abdelrahmaneldeib/sumo-robot/rendering/prototype IR with PCB 1.jpg

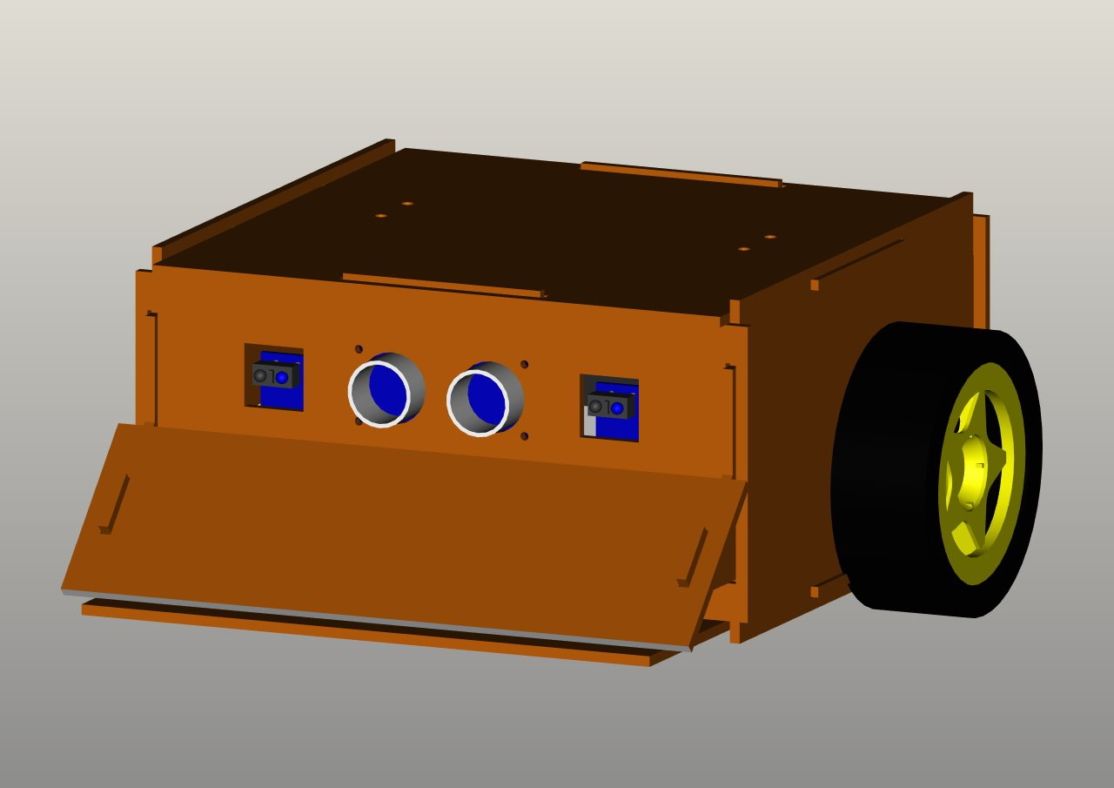
rendering/prototype IR with PCB 1.jpg
