abdelrahmaneldeib/sumo-robot/PCB/final/WhatsApp Image 2023-05-24 at 13.45.49.jpg

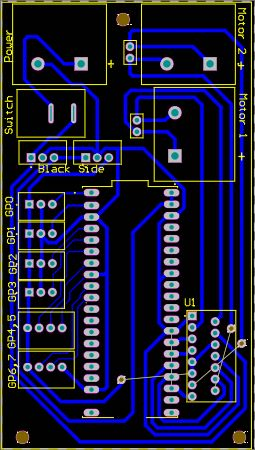
PCB/final/WhatsApp Image 2023-05-24 at 13.45.49.jpg
