abdelrahmaneldeib/sumo-robot/README.md

# sumo-robot
Welcome to an exciting project that showcases the design and development of a Sumo robot tailored to meet the specific goals and requirements of our esteemed client This project not only emphasizes technical prowess but also ingenuity and creativity in engineering solutions.
