abdelrahmaneldeib/sumo-robot/rendering/prototype IR with PCB 2.jpg

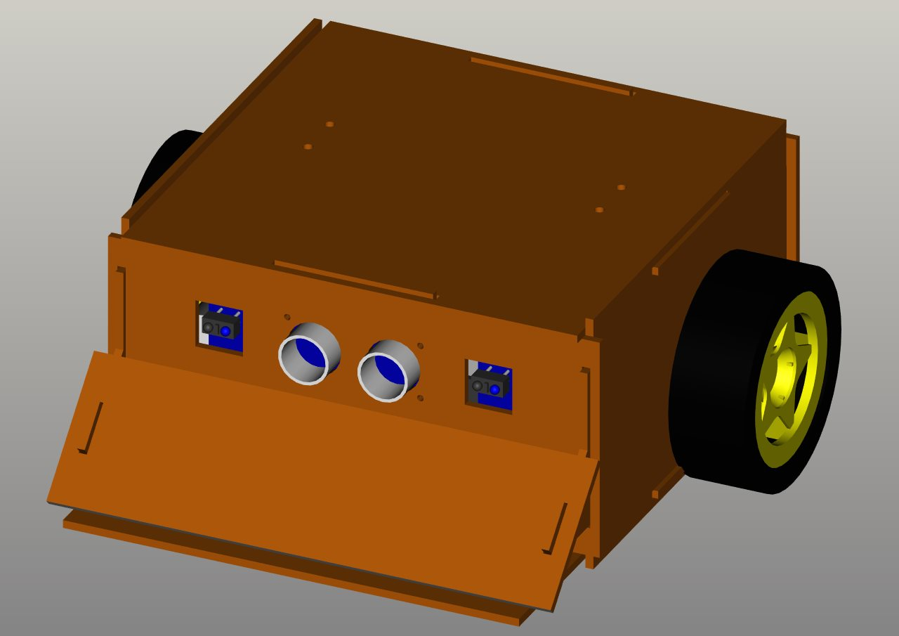
rendering/prototype IR with PCB 2.jpg
