abdelrahmaneldeib/sumo-robot/rendering/prototype IR with PCB 3.jpg

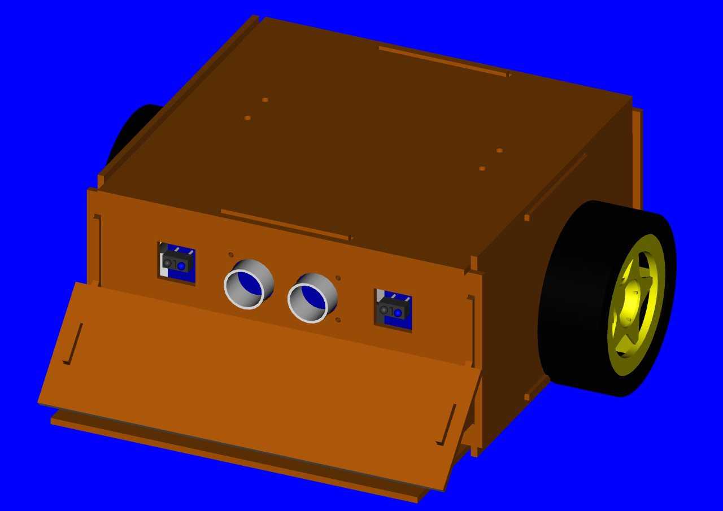
rendering/prototype IR with PCB 3.jpg
