abdelrahmaneldeib/sumo-robot/rendering/prototype IR with PCB 4.jpg

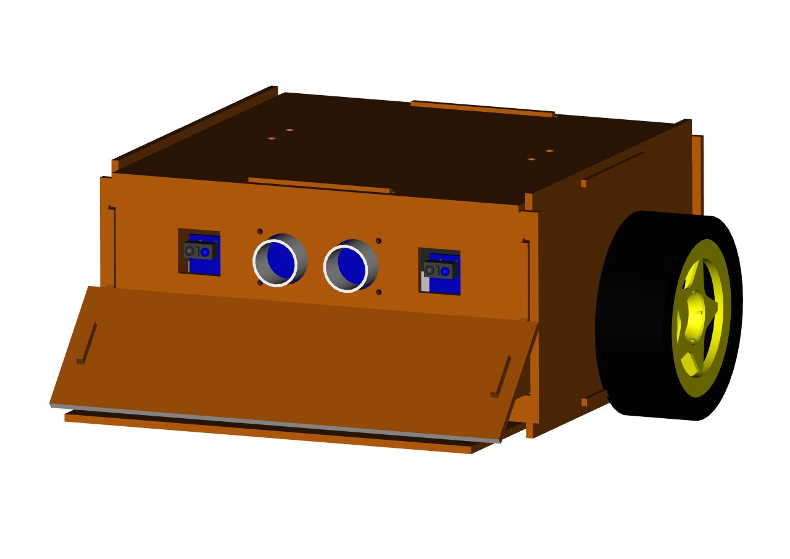
rendering/prototype IR with PCB 4.jpg
