abdelrahmaneldeib/sumo-robot/Design/prototype/prototype US.SLDASM

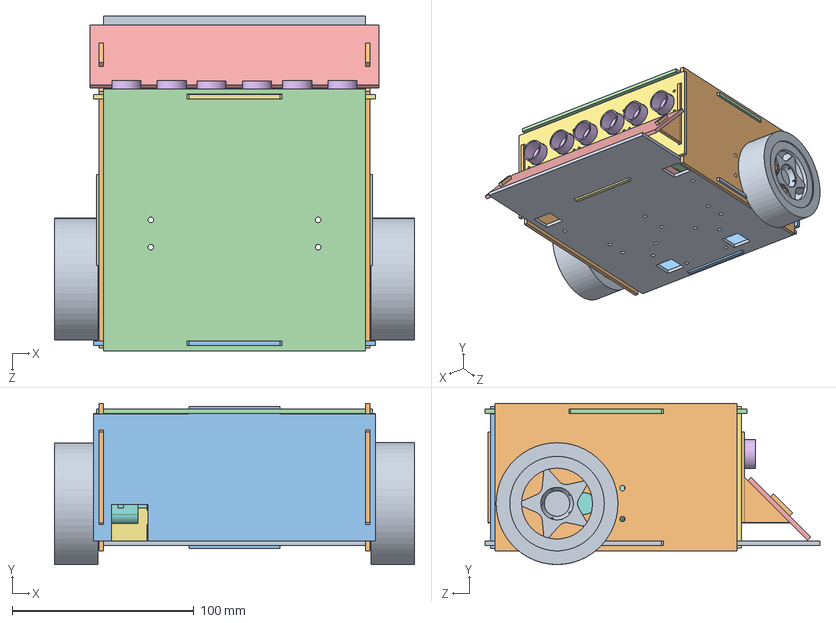
[picture p28: CAD file, 2024-05-13]
Design/prototype/prototype US.SLDASM
198.0 x 88.7 x 184.2 mm
bottom
side x 2
back
battery holder
breadboard x 2
IR sensor x 4
motor driver
motor x 2
wheel x 2
black disk x 2
encoder x 2
top
defender
ultrasonic sensor x 3
front2
