abdelrahmaneldeib/sumo-robot/Design/prototype/prototype IR with PCB.SLDASM

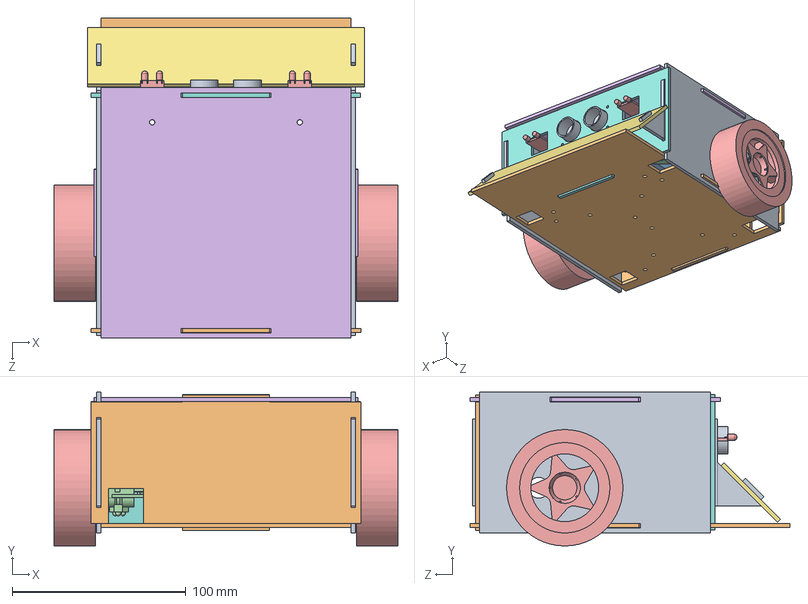
[picture p29: CAD file, 2024-05-13]
Design/prototype/prototype IR with PCB.SLDASM
198.0 x 88.6 x 184.3 mm
side x 2
back
battery holder
motor x 2
wheel x 2
top
defender
front
ultrasonic sensor
bottom2
PCB
IR sensor x 4
IR sensor 2 x 2
