abdelrahmaneldeib/sumo-robot/Design/final/battery holder 4 batteries.SLDPRT

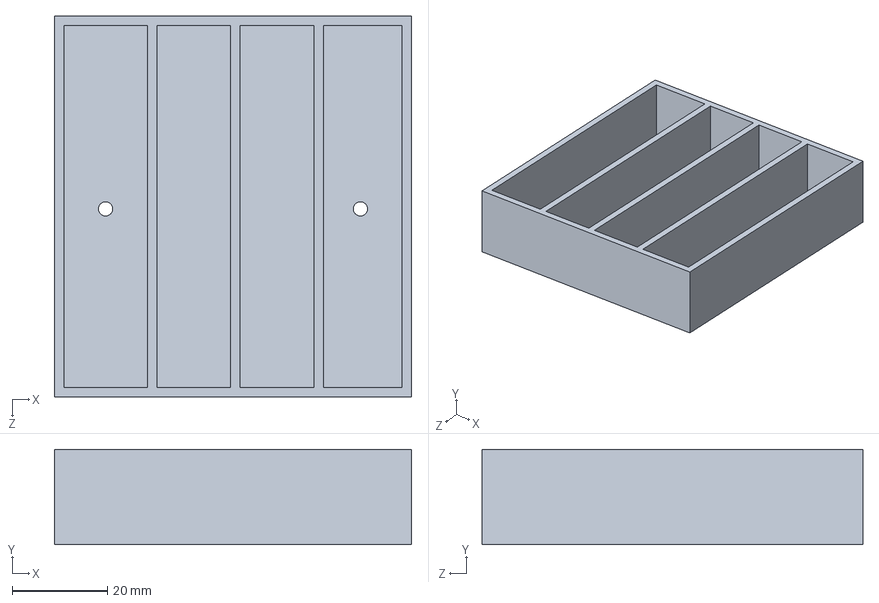
[picture p30: CAD file, 2024-05-13]
Design/final/battery holder 4 batteries.SLDPRT
75.0 x 20.0 x 80.0 mm
