abdelrahmaneldeib/sumo-robot/Design/final/top.SLDPRT

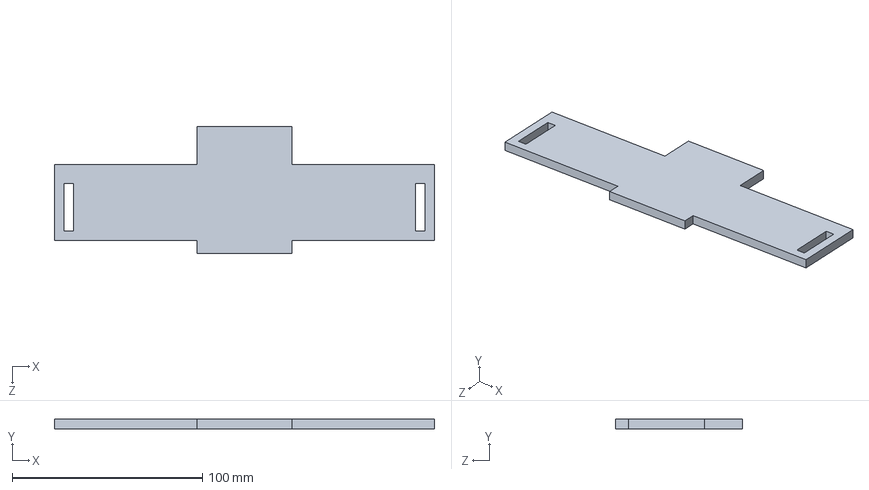
[picture p31: CAD file, 2024-05-13]
Design/final/top.SLDPRT
200.0 x 5.00 x 67.0 mm
