abdelrahmaneldeib/sumo-robot/Design/prototype/ultrasonic sensor.SLDPRT

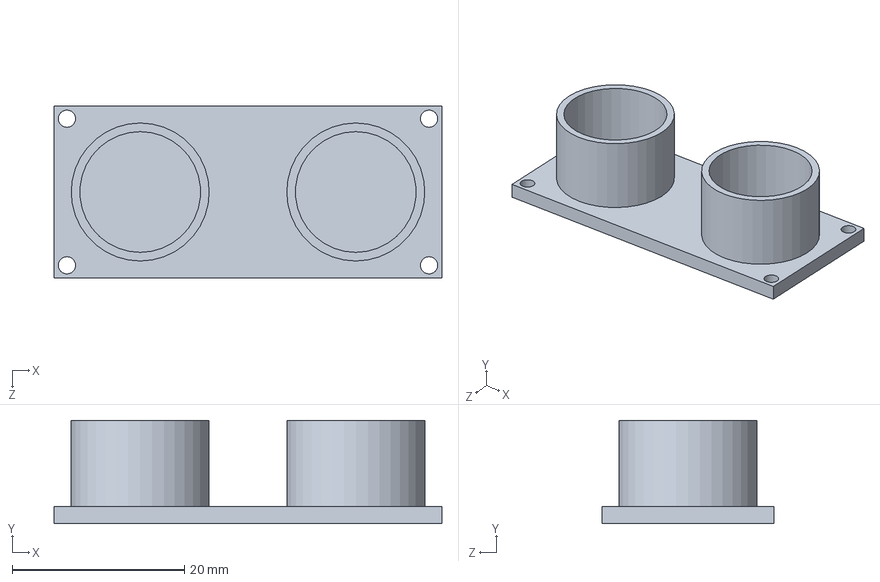
[picture p32: CAD file, 2024-05-13]
Design/prototype/ultrasonic sensor.SLDPRT
45.0 x 12.0 x 20.0 mm
