abdelrahmaneldeib/sumo-robot/Design/final/back.SLDPRT

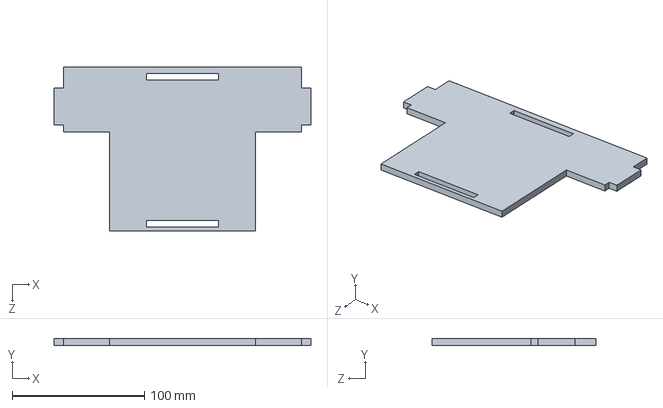
[picture p33: CAD file, 2024-05-13]
Design/final/back.SLDPRT
194.0 x 5.00 x 124.0 mm
