abdelrahmaneldeib/sumo-robot/Design/prototype/breadboard.SLDPRT

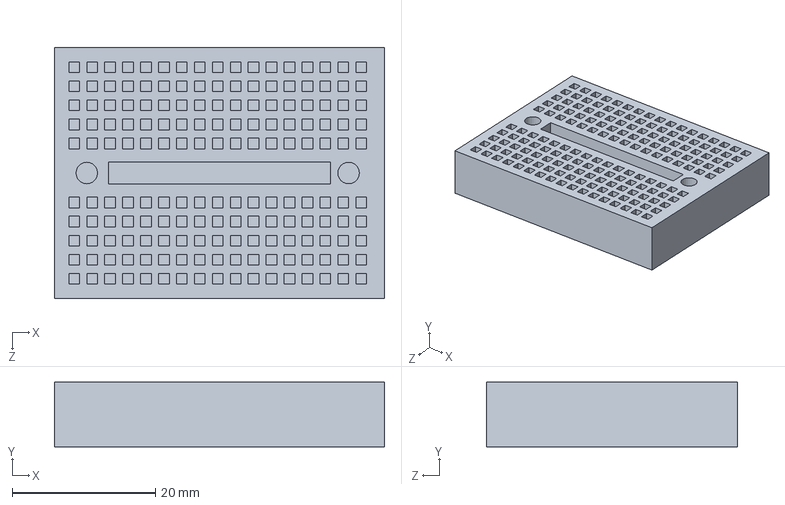
[picture p34: CAD file, 2024-05-13]
Design/prototype/breadboard.SLDPRT
46.0 x 9.00 x 35.0 mm
