abdelrahmaneldeib/sumo-robot/Design/final/DC motor 12V 133RPM.SLDPRT

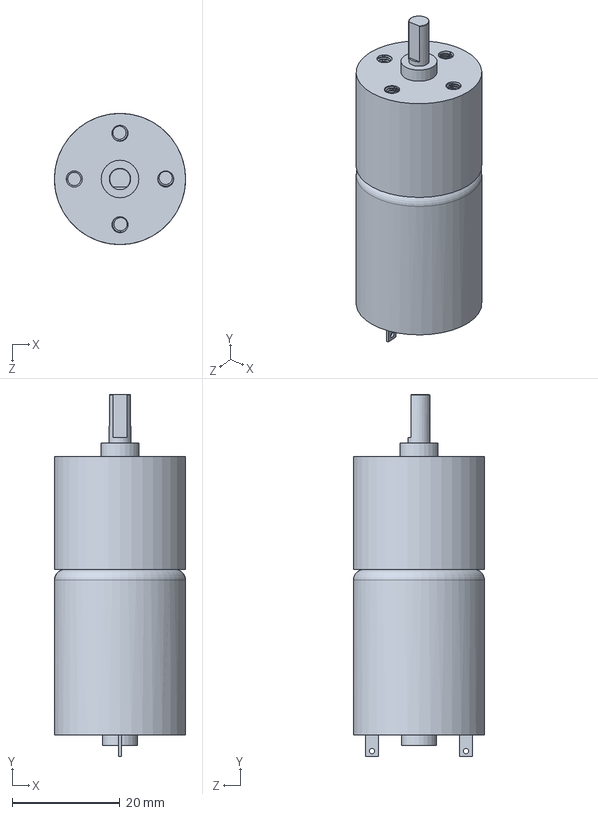
[picture p35: CAD file, 2024-05-13]
Design/final/DC motor 12V 133RPM.SLDPRT
24.4 x 67.3 x 24.4 mm
