abdelrahmaneldeib/sumo-robot/Design/final/artelon masry2 9mm.DXF

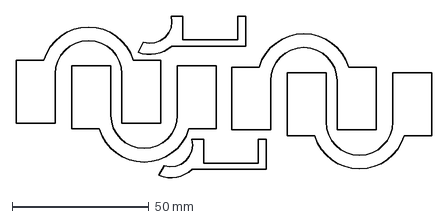
[picture p37: CAD file, 2024-05-13]
Design/final/artelon masry2 9mm.DXF
151.9 x 59.9 mm
