abdelrahmaneldeib/sumo-robot/Design/prototype/front2.SLDPRT

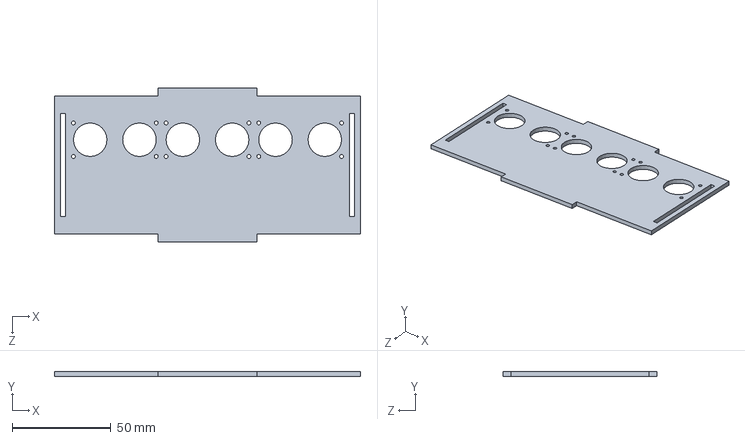
[picture p38: CAD file, 2024-05-13]
Design/prototype/front2.SLDPRT
155.2 x 2.50 x 78.0 mm
