abdelrahmaneldeib/sumo-robot/Design/final/weight.SLDPRT

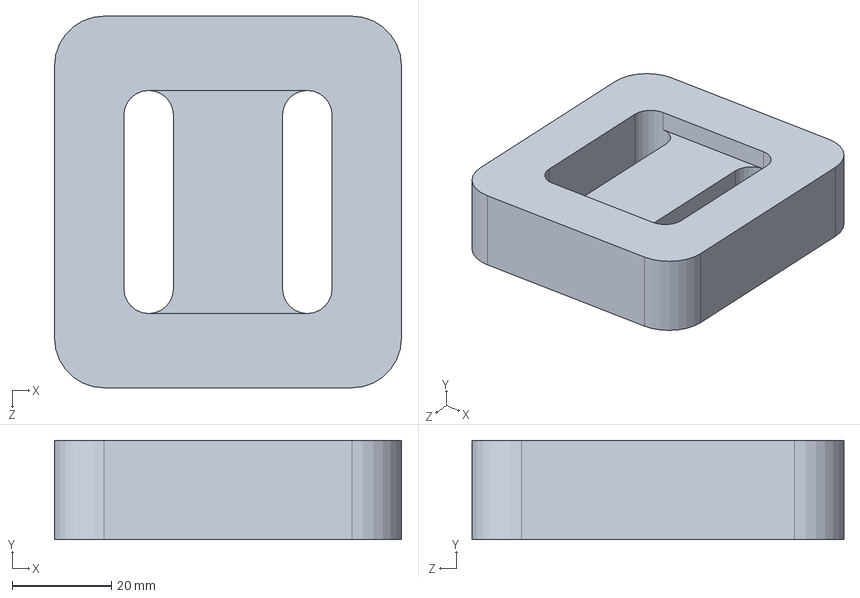
[picture p39: CAD file, 2024-05-13]
Design/final/weight.SLDPRT
70.0 x 20.0 x 75.0 mm
