abdelrahmaneldeib/sumo-robot/Design/prototype/IR sensor 2.SLDPRT

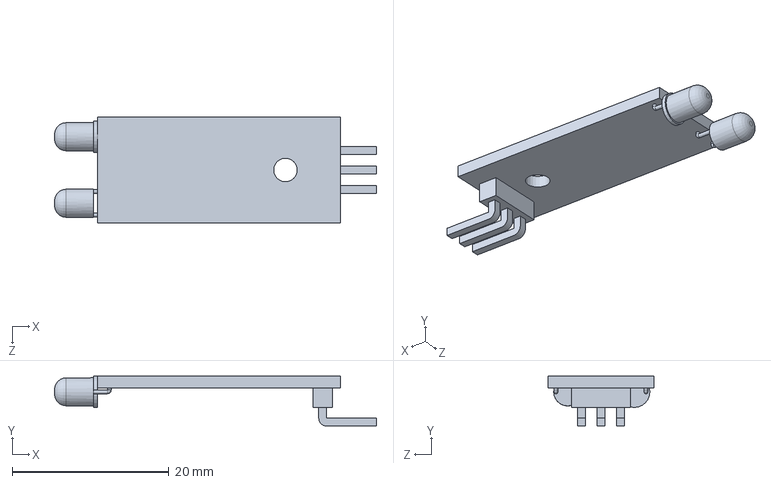
[picture p40: CAD file, 2024-05-13]
Design/prototype/IR sensor 2.SLDPRT
41.1 x 6.38 x 13.5 mm
