abdelrahmaneldeib/sumo-robot/Design/final/lower afiz.SLDPRT

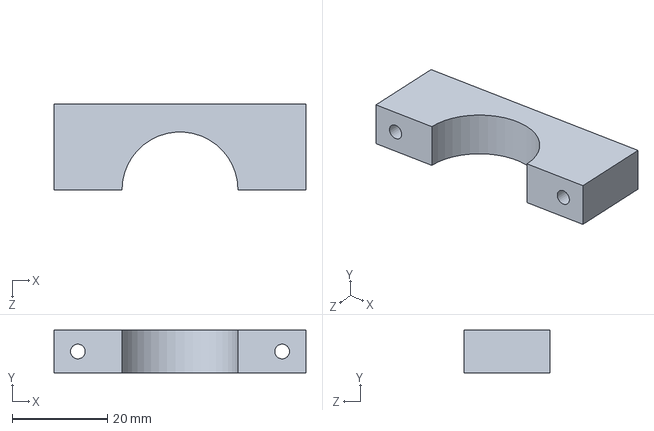
[picture p41: CAD file, 2024-05-13]
Design/final/lower afiz.SLDPRT
52.8 x 9.00 x 18.0 mm
