abdelrahmaneldeib/sumo-robot/Design/prototype/side.SLDPRT

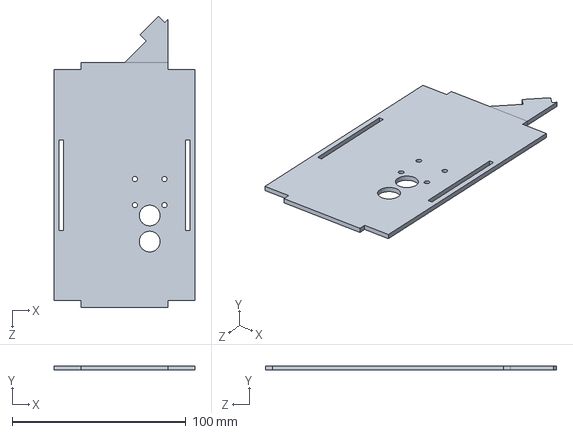
[picture p42: CAD file, 2024-05-13]
Design/prototype/side.SLDPRT
81.2 x 2.50 x 167.6 mm
