abdelrahmaneldeib/sumo-robot/Design/final/wheel.SLDPRT

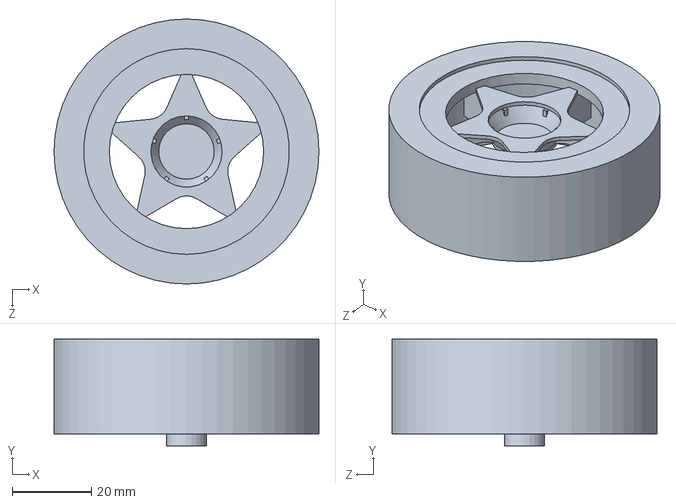
[picture p43: CAD file, 2024-05-13]
Design/final/wheel.SLDPRT
67.0 x 27.0 x 67.0 mm
