abdelrahmaneldeib/sumo-robot/Design/prototype/defender.SLDPRT

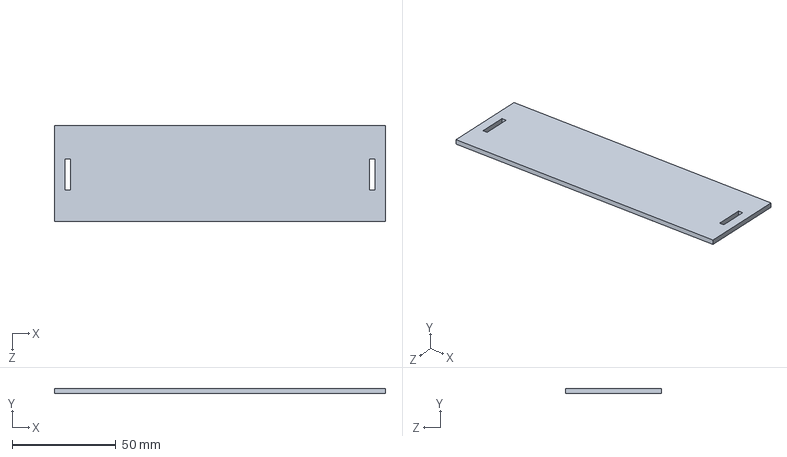
[picture p44: CAD file, 2024-05-13]
Design/prototype/defender.SLDPRT
159.2 x 2.50 x 46.0 mm
