abdelrahmaneldeib/sumo-robot/Design/final/coupler.SLDPRT

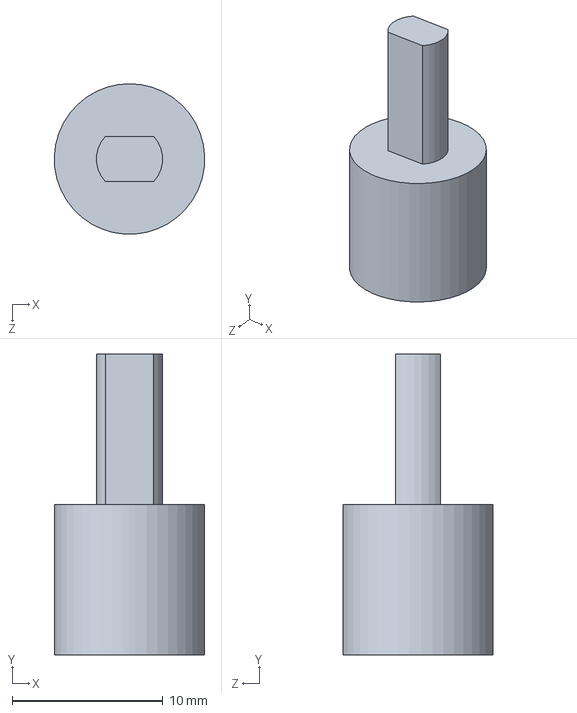
[picture p45: CAD file, 2024-05-13]
Design/final/coupler.SLDPRT
9.99 x 20.0 x 10.0 mm
