abdelrahmaneldeib/sumo-robot/Design/prototype/encoder.SLDPRT

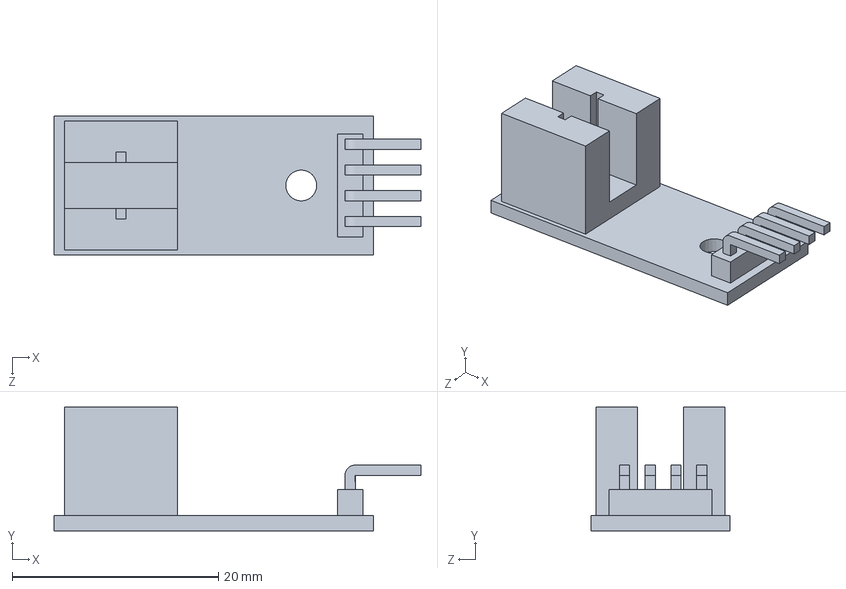
[picture p46: CAD file, 2024-05-13]
Design/prototype/encoder.SLDPRT
35.6 x 12.0 x 13.5 mm
