abdelrahmaneldeib/sumo-robot/Design/final/ultrasonic fixation.SLDPRT

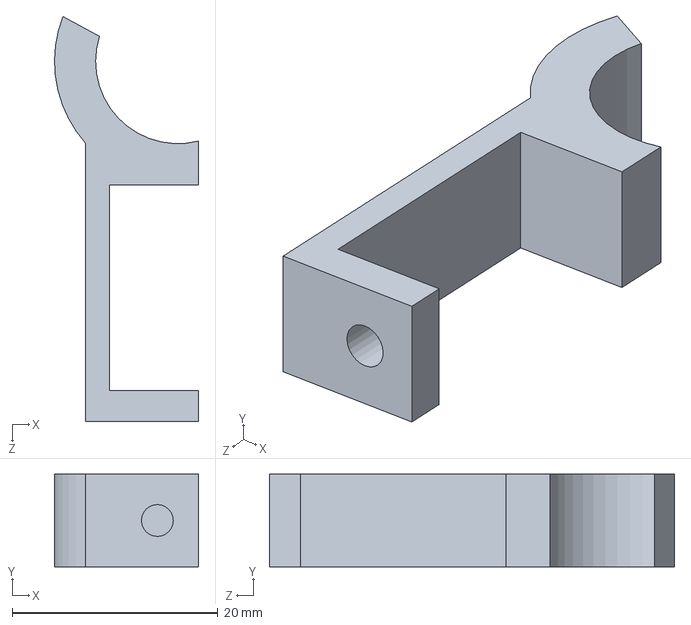
[picture p47: CAD file, 2024-05-13]
Design/final/ultrasonic fixation.SLDPRT
14.0 x 9.00 x 39.4 mm
