abdelrahmaneldeib/sumo-robot/Design/final/sideL.SLDPRT

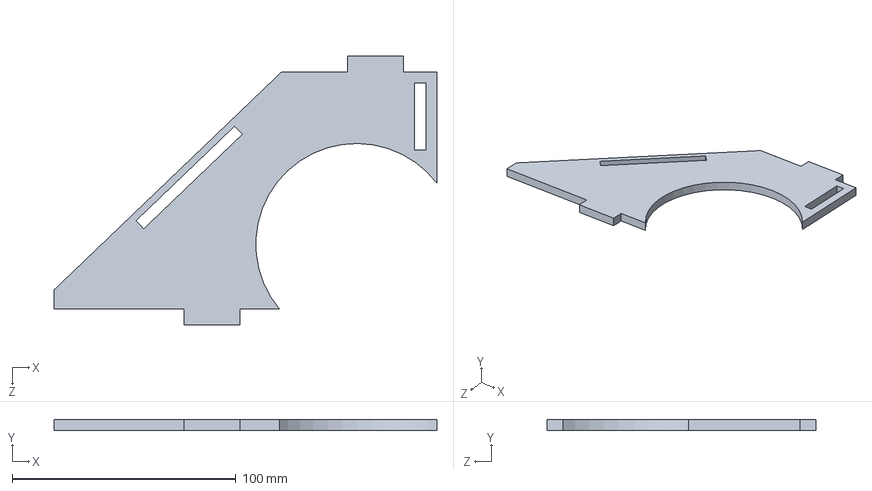
[picture p48: CAD file, 2024-05-13]
Design/final/sideL.SLDPRT
171.0 x 5.00 x 120.0 mm
