abdelrahmaneldeib/sumo-robot/Design/prototype/PCB.SLDPRT

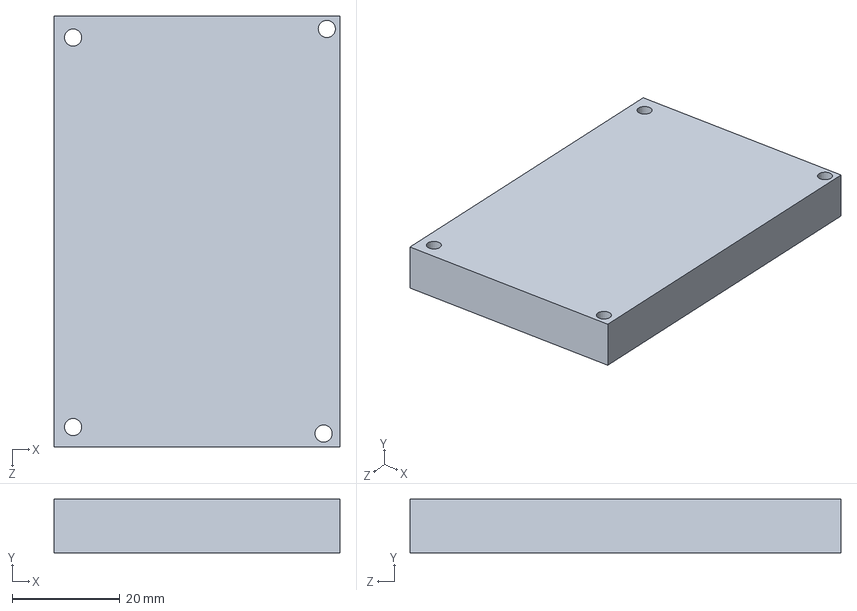
[picture p49: CAD file, 2024-05-13]
Design/prototype/PCB.SLDPRT
53.0 x 10.0 x 80.0 mm
