abdelrahmaneldeib/sumo-robot/Design/prototype/IR sensor.SLDPRT

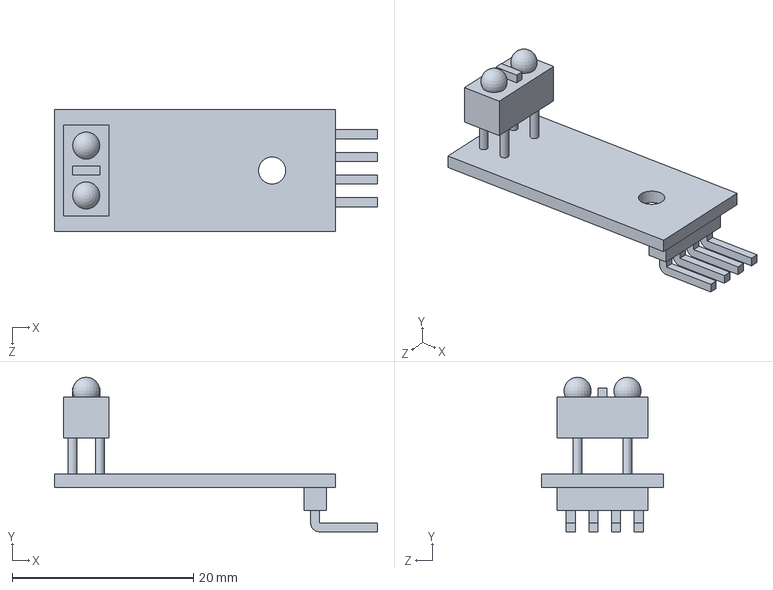
[picture p50: CAD file, 2024-05-13]
Design/prototype/IR sensor.SLDPRT
35.6 x 17.1 x 13.5 mm
