abdelrahmaneldeib/sumo-robot/Design/final/sheet metal.SLDPRT

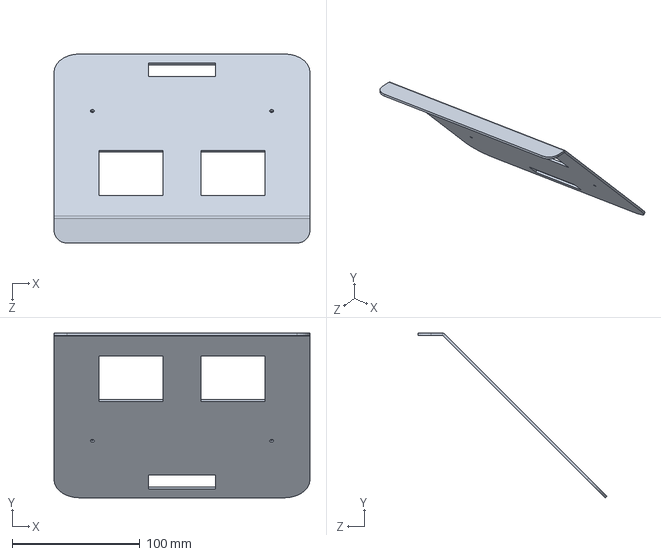
[picture p51: CAD file, 2024-05-13]
Design/final/sheet metal.SLDPRT
200.0 x 128.7 x 147.7 mm
