abdelrahmaneldeib/sumo-robot/Design/prototype/battery holder.SLDPRT

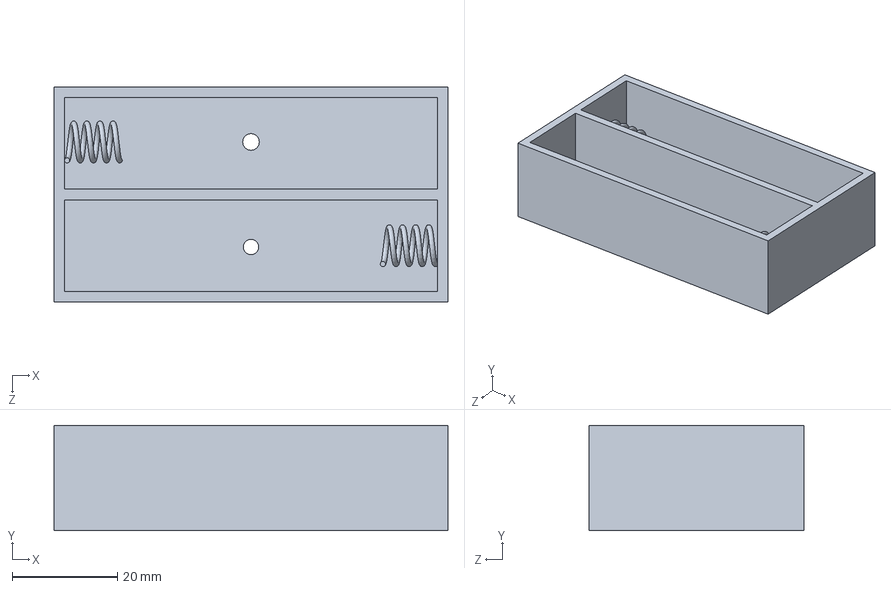
[picture p52: CAD file, 2024-05-13]
Design/prototype/battery holder.SLDPRT
75.0 x 20.0 x 41.0 mm
