abdelrahmaneldeib/sumo-robot/Design/final/plate.SLDPRT

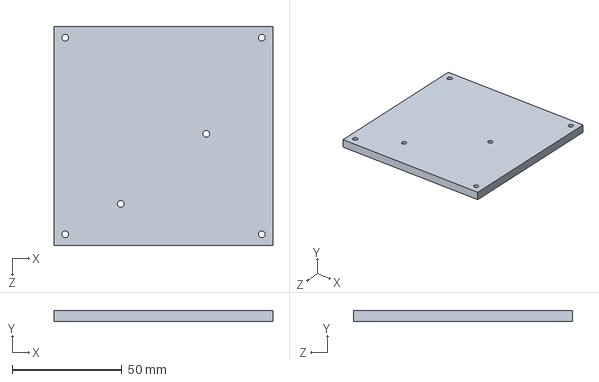
[picture p53: CAD file, 2024-05-13]
Design/final/plate.SLDPRT
100.0 x 5.00 x 100.0 mm
