abdelrahmaneldeib/sumo-robot/Design/final/front.SLDPRT

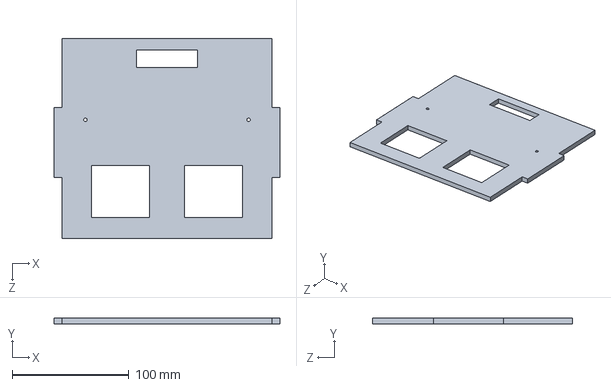
[picture p54: CAD file, 2024-05-13]
Design/final/front.SLDPRT
194.0 x 5.00 x 172.0 mm
