abdelrahmaneldeib/sumo-robot/Design/prototype/motor driver.SLDPRT

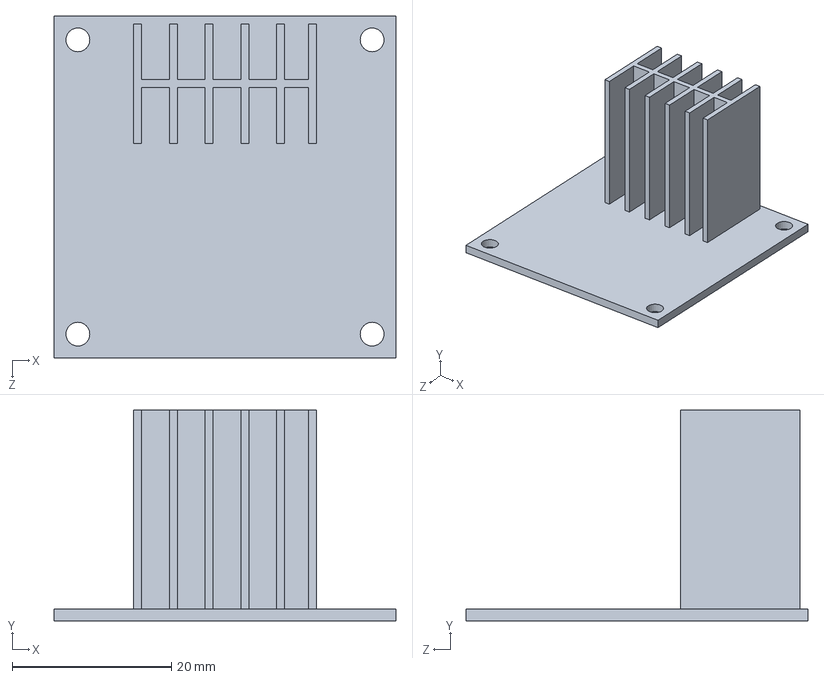
[picture p55: CAD file, 2024-05-13]
Design/prototype/motor driver.SLDPRT
43.0 x 26.5 x 43.0 mm
