abdelrahmaneldeib/sumo-robot/Design/prototype/bottom.SLDPRT

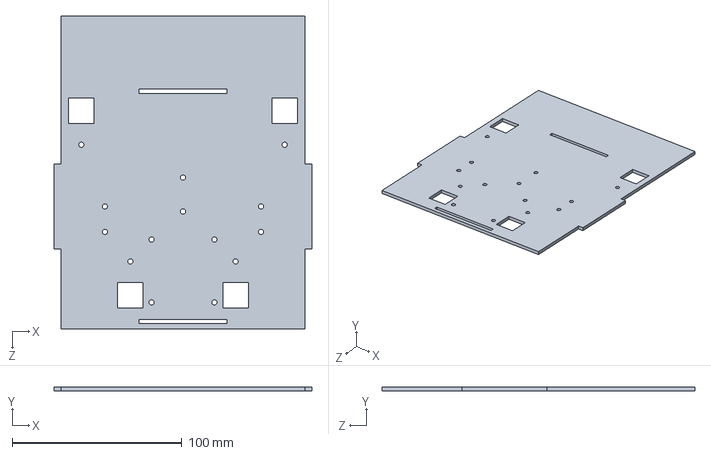
[picture p56: CAD file, 2024-05-13]
Design/prototype/bottom.SLDPRT
152.0 x 2.50 x 184.2 mm
