abdelrahmaneldeib/sumo-robot/Design/final/54b 2 5mm.DXF

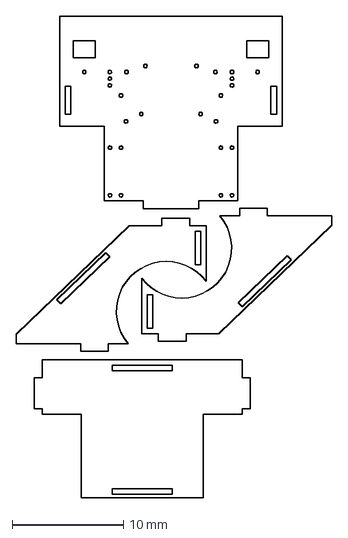
[picture p57: CAD file, 2024-05-13]
Design/final/54b 2 5mm.DXF
28.4 x 43.3 mm
