abdelrahmaneldeib/sumo-robot/Design/prototype/motor.SLDPRT

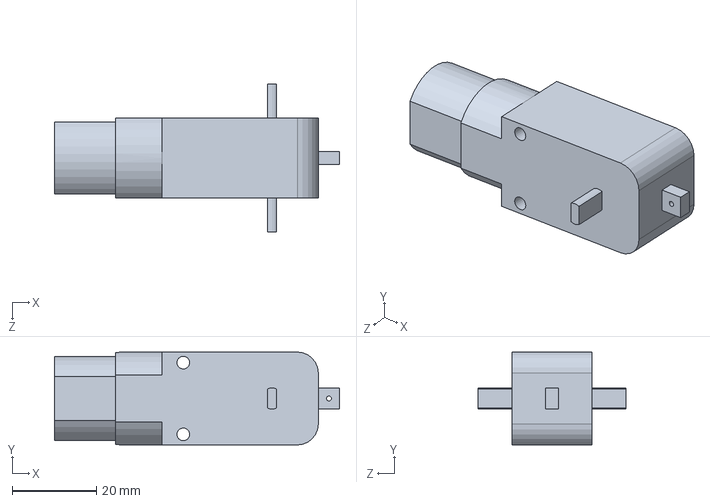
[picture p58: CAD file, 2024-05-13]
Design/prototype/motor.SLDPRT
67.5 x 22.0 x 35.0 mm
