abdelrahmaneldeib/sumo-robot/Design/prototype/top.SLDPRT

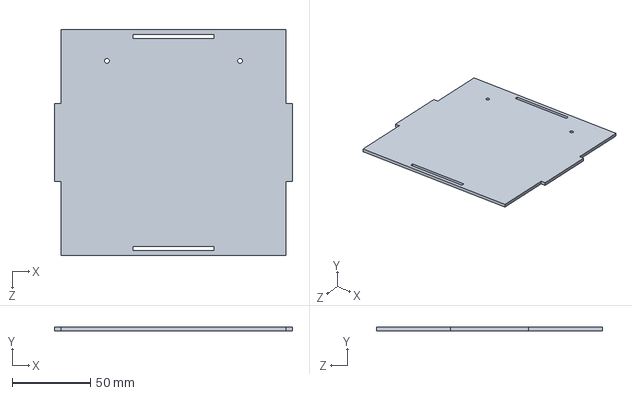
[picture p59: CAD file, 2024-05-13]
Design/prototype/top.SLDPRT
152.0 x 2.50 x 144.2 mm
