abdelrahmaneldeib/sumo-robot/Design/final/upper afiz.SLDPRT

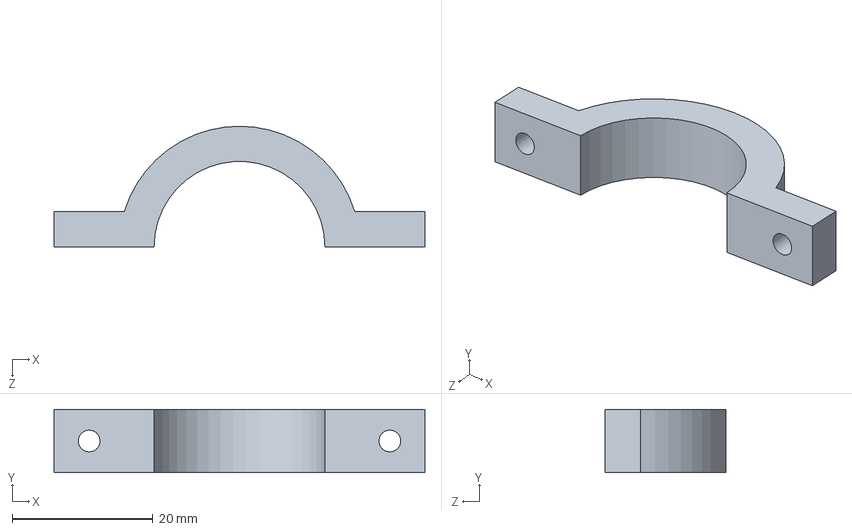
[picture p60: CAD file, 2024-05-13]
Design/final/upper afiz.SLDPRT
52.8 x 9.00 x 17.1 mm
