abdelrahmaneldeib/sumo-robot/Design/prototype/black disk.SLDPRT

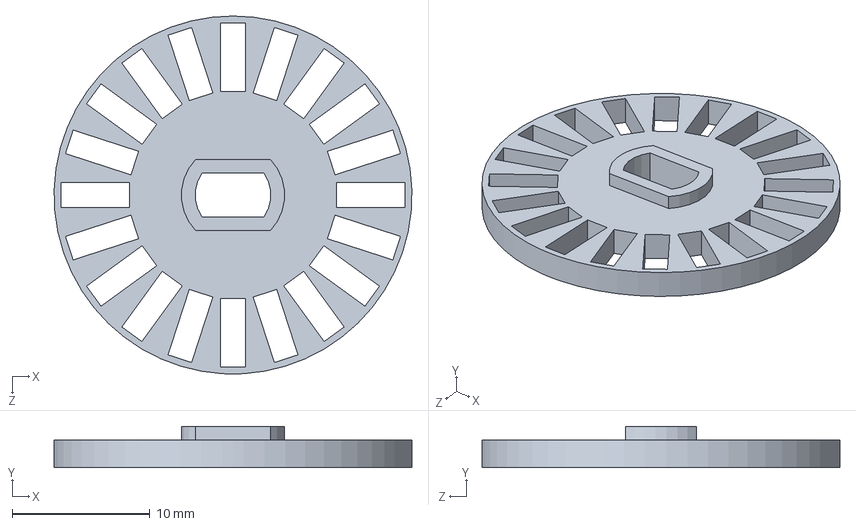
[picture p61: CAD file, 2024-05-13]
Design/prototype/black disk.SLDPRT
26.0 x 3.00 x 26.0 mm
