abdelrahmaneldeib/sumo-robot/Design/final/new wheel.SLDPRT

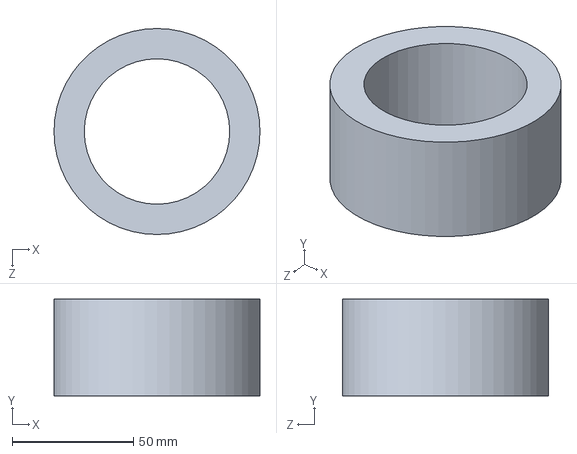
[picture p62: CAD file, 2024-05-13]
Design/final/new wheel.SLDPRT
85.0 x 40.0 x 85.0 mm
