abdelrahmaneldeib/sumo-robot/Design/final/bottom.SLDPRT

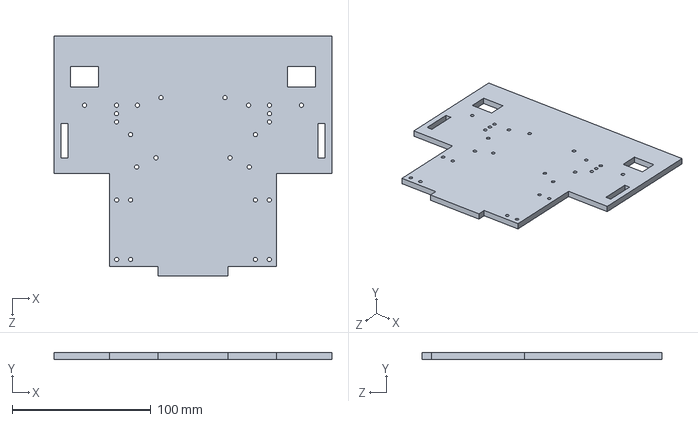
[picture p63: CAD file, 2024-05-13]
Design/final/bottom.SLDPRT
200.0 x 5.00 x 173.0 mm
