abdelrahmaneldeib/sumo-robot/(list of files, cad)

Other CAD files:
Design/prototype/prototype IR.SLDASM
Design/prototype/sketch of top 2.SLDPRT
Design/final/sketch of 54b 2.SLDPRT
Design/prototype/sketch bottom 2.SLDPRT
Design/final/54b 5mm.SLDPRT
Design/final/IR sensor 2.SLDPRT
Design/final/artelon masry 9mm.SLDPRT
Design/prototype/sketch1.SLDPRT
Design/prototype/bottom2.SLDPRT
Design/prototype/back.SLDPRT
Design/prototype/sketch of bottom.SLDPRT
Design/final/54b 5mm.DXF
Design/final/artelon masry 9mm.DXF
Design/final/coupler.STL
Design/final/sheet metal.DXF
Design/prototype/sketch bottom 2.DXF
Design/prototype/sketch of bottom.DXF
Design/prototype/sketch of top 2.DXF
Design/prototype/sketch1.DXF
