abdelrahmaneldeib/sumo-robot/PCB/prototype/my design/sumobot PCB schematic.pdf

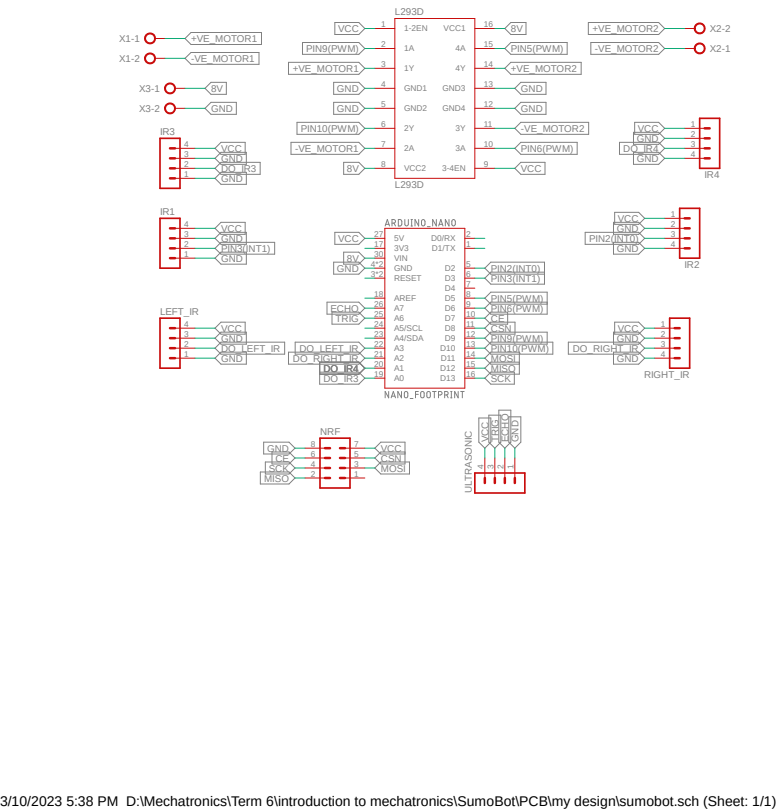
[picture p64: page 1]

3/10/2023 5:38 PM D:\Mechatronics\Term 6\introduction to mechatronics\SumoBot\PCB\my design\sumobot.sch (Sheet: 1/1)
