abdelrahmaneldeib/sumo-robot/presentation/prototype/sumo robot control system.pdf

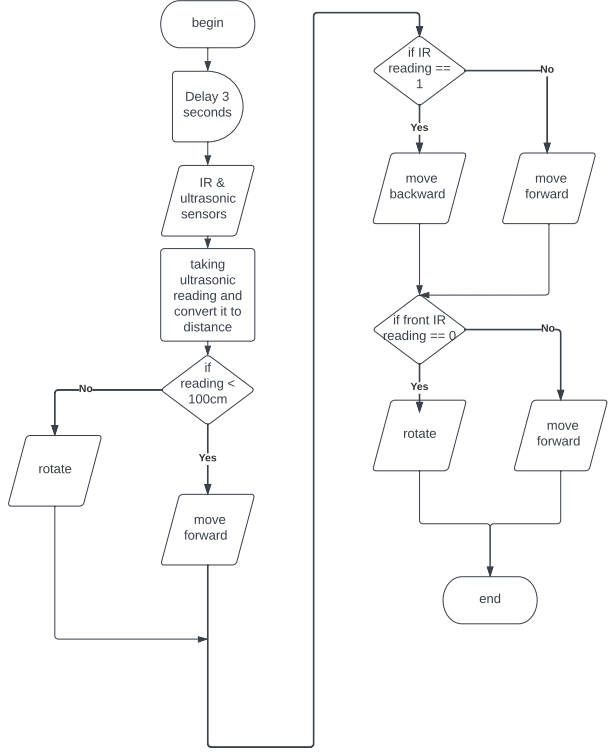
[picture p65: page 1]
begin; Delay 3 seconds; IR & ultrasonic sensors; if reading < 100cm; move forward; Yes; rotate; if IR reading == 1; move backward; end

taking
ultrasonic
reading and
convert it to
distance

if front IR
reading == 0
