abdelrahmaneldeib/sumo-robot/PCB/final/pcb.pdf

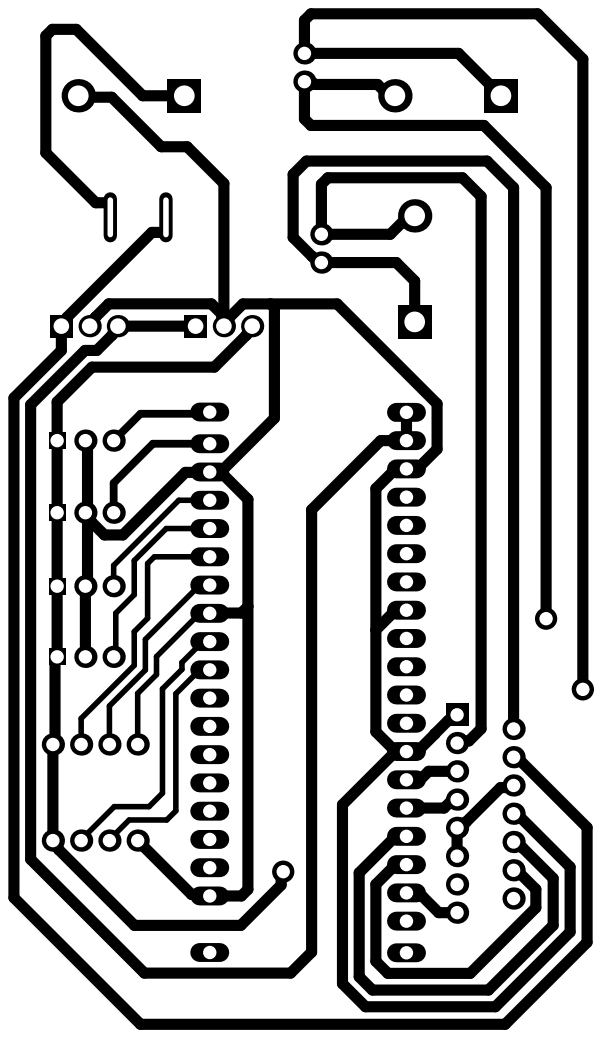
[picture p66: page 1]
