abdelrahmaneldeib/sumo-robot/PCB/final/sticker.pdf

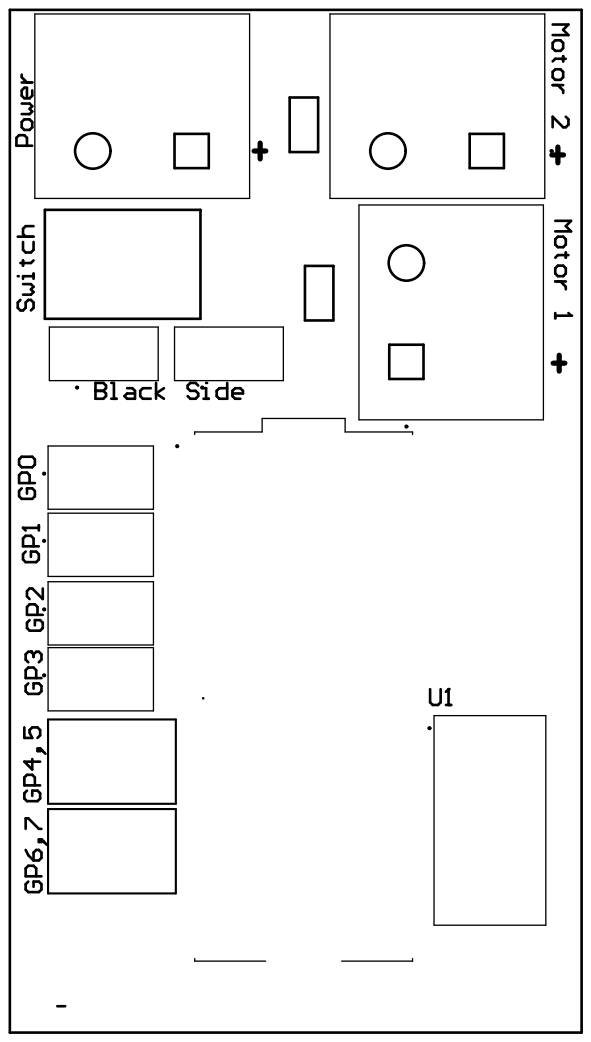
[picture p67: page 1]
