abdelrahmaneldeib/sumo-robot/(list of files, drawings)

Other design files:
PCB/final/PCB2.PcbDoc
PCB/final/PcbLib1.PcbLib
PCB/final/Schlib1.SchLib
PCB/final/Sheet2.SchDoc
PCB/final/sumobot_final.PrjPcb
PCB/prototype/sumobot PCB/PCB1 (1).PcbDoc
PCB/prototype/sumobot PCB/PCB1 (2).PcbDoc
PCB/prototype/sumobot PCB/PCB1.PcbDoc
PCB/prototype/sumobot PCB/PcbLib1.PcbLib
PCB/prototype/sumobot PCB/Schlib1.SchLib
PCB/prototype/sumobot PCB/Sheet1.SchDoc
