abdelrahmaneldeib/sumo-robot/PCB/prototype/my design/sumobot.brd

## EAGLE design PCB/prototype/my design/sumobot.brd (2024-05-13)

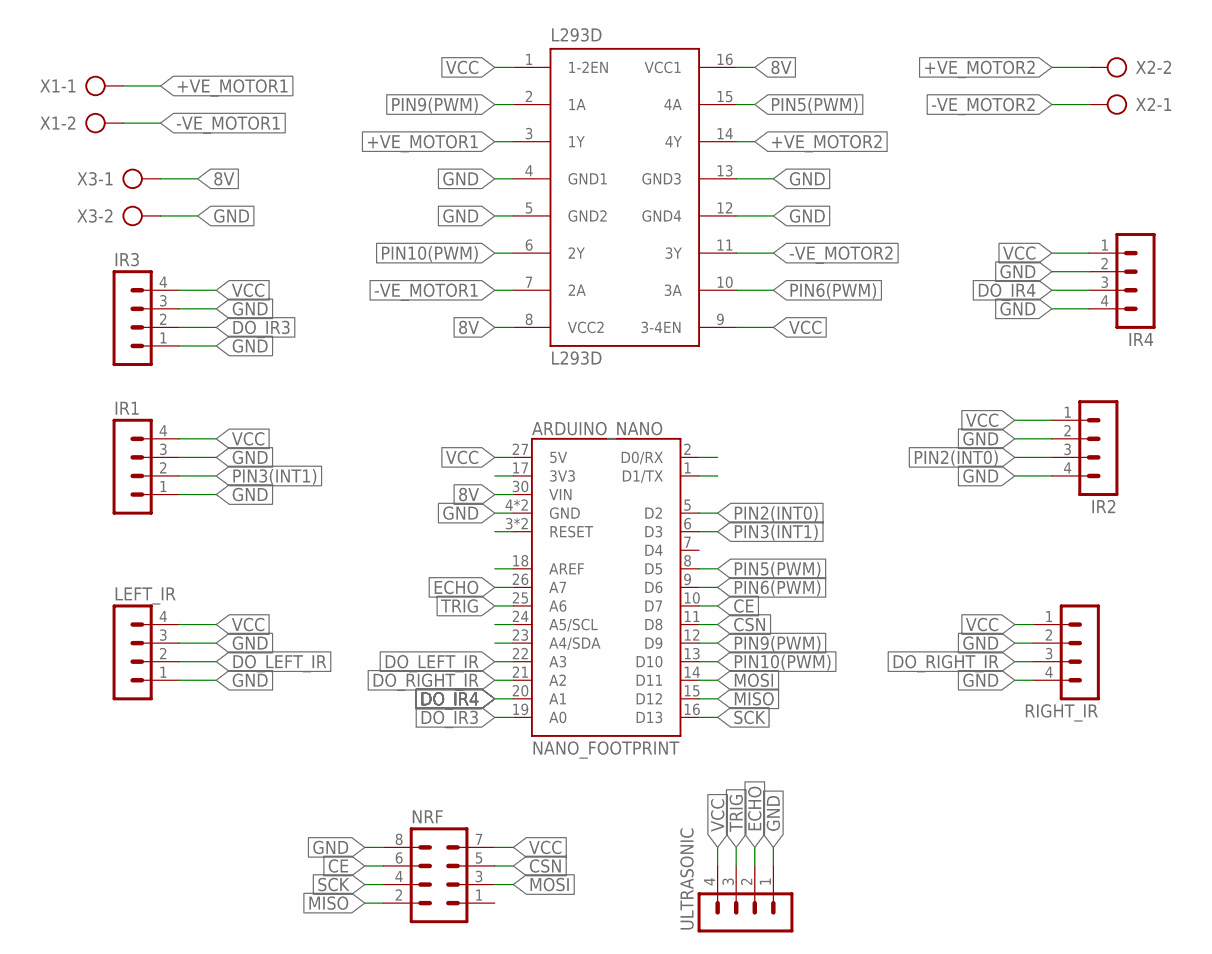
[picture p68: schematic sumobot.sch]

Parts:
ARDUINO_NANO: NANO_FOOTPRINT; NANO
IR1, IR2, IR3, IR4: MA04-1
L293D: L293D; DIL16
LEFT_IR: MA04-1
NRF: MA04-2
RIGHT_IR: MA04-1
ULTRASONIC: MA04-1
X1, X2, X3: AK500/2

Connections:
8V: ARDUINO_NANO.30 (VIN), L293D.8 (VCC2), L293D.16 (VCC1), X3.1
+VE_MOTOR1: L293D.3 (1Y), X1.1
+VE_MOTOR2: L293D.14 (4Y), X2.2
-VE_MOTOR1: L293D.7 (2A), X1.2
-VE_MOTOR2: L293D.11 (3Y), X2.1
CE: ARDUINO_NANO.10 (D7), NRF.6
CSN: ARDUINO_NANO.11 (D8), NRF.5
DO_IR3: ARDUINO_NANO.19 (A0), IR3.2
DO_IR4: ARDUINO_NANO.20 (A1), IR4.3
DO_LEFT_IR: ARDUINO_NANO.22 (A3), LEFT_IR.2
DO_RIGHT_IR: ARDUINO_NANO.21 (A2), RIGHT_IR.3
ECHO: ARDUINO_NANO.26 (A7), ULTRASONIC.2
GND: ARDUINO_NANO.4 (GND), ARDUINO_NANO.29 (GND), IR1.1, IR1.3, IR2.2, IR2.4, IR3.1, IR3.3, IR4.2, IR4.4, L293D.4 (GND1), L293D.5 (GND2), L293D.12 (GND4), L293D.13 (GND3), LEFT_IR.1, LEFT_IR.3, NRF.8, RIGHT_IR.2, RIGHT_IR.4, ULTRASONIC.1, X3.2
MISO: ARDUINO_NANO.15 (D12), NRF.2
MOSI: ARDUINO_NANO.14 (D11), NRF.3
unnamed: ARDUINO_NANO.3 (RESET), ARDUINO_NANO.28 (RESET)
PIN2(INT0): ARDUINO_NANO.5 (D2), IR2.3
PIN3(INT1): ARDUINO_NANO.6 (D3), IR1.2
PIN5(PWM): ARDUINO_NANO.8 (D5), L293D.15 (4A)
PIN6(PWM): ARDUINO_NANO.9 (D6), L293D.10 (3A)
PIN9(PWM): ARDUINO_NANO.12 (D9), L293D.2 (1A)
PIN10(PWM): ARDUINO_NANO.13 (D10), L293D.6 (2Y)
SCK: ARDUINO_NANO.16 (D13), NRF.4
TRIG: ARDUINO_NANO.25 (A6), ULTRASONIC.3
VCC: ARDUINO_NANO.27 (5V), IR1.4, IR2.1, IR3.4, IR4.1, L293D.1 (1-2EN), L293D.9 (3-4EN), LEFT_IR.4, NRF.7, RIGHT_IR.1, ULTRASONIC.4

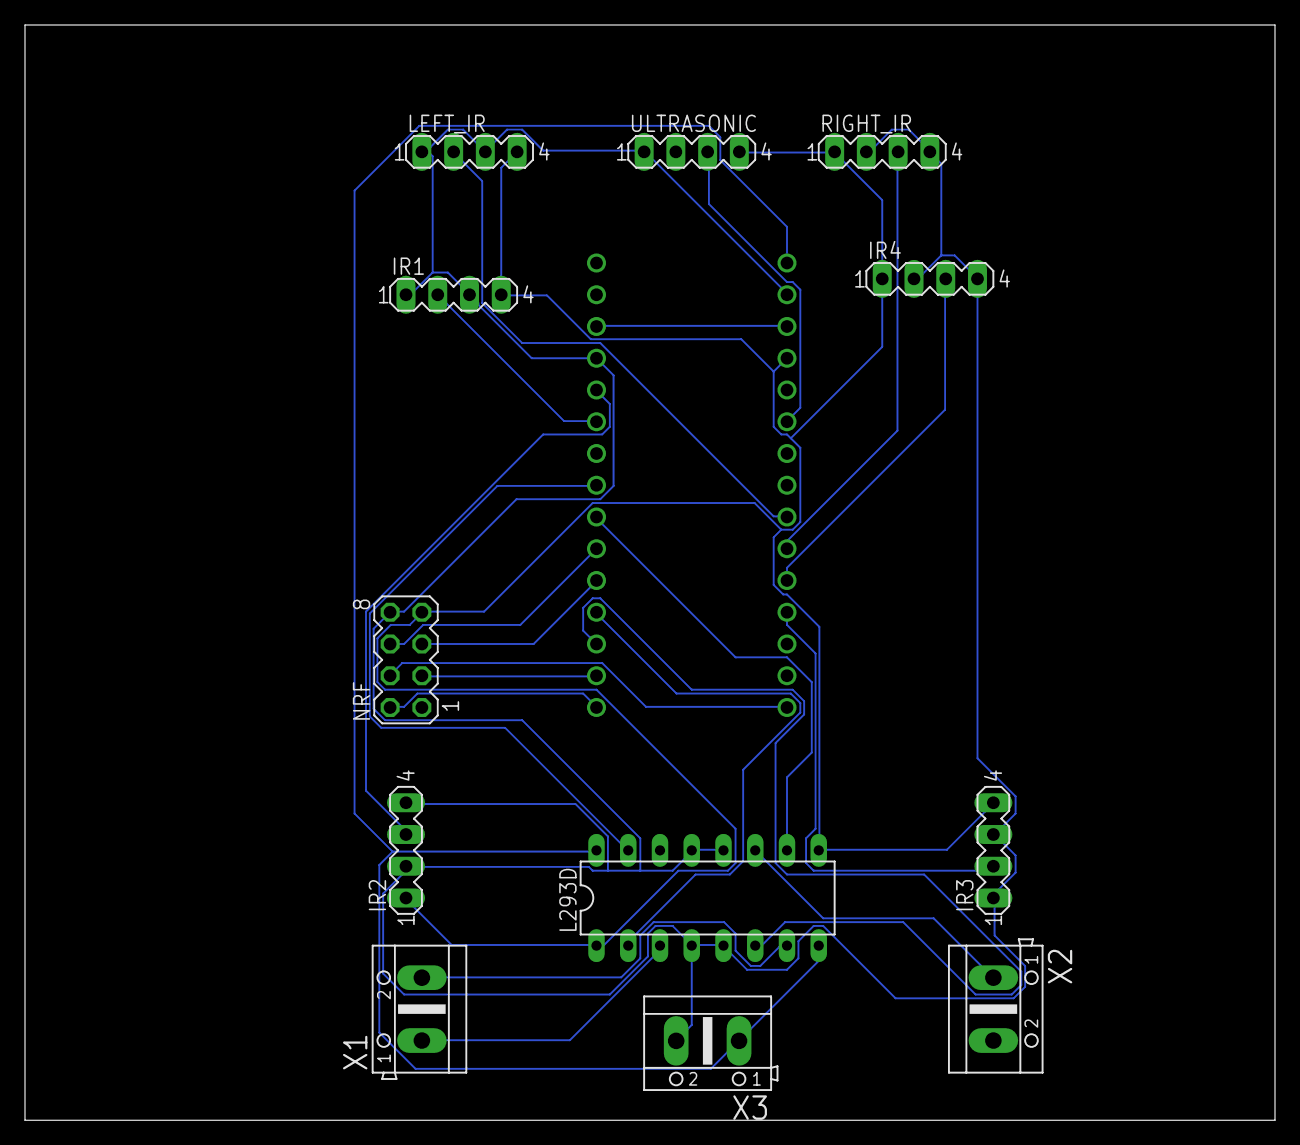
[picture p69: board sumobot.brd from above]

Board: 2 copper layers, 100.0 x 87.6 mm, 13 parts (0 on the bottom side), 25 nets.
