abdelrahmaneldeib/sumo-robot/code/arduino/NRF/simple_receiver/simple_receiver.ino

#include <SPI.h>
#include <nRF24L01.h>
#include <RF24.h>
RF24 radio(7, 8);
const byte address[6] = "00001";

void setup() 
{
  Serial.begin(9600);
  radio.begin();
  radio.openReadingPipe(0, address);
  radio.setPALevel(RF24_PA_MIN);
  radio.startListening();
  pinMode(13,OUTPUT);
}

void loop() 
{
if (radio.available()) 
{
  char text[] = "";
  radio.read(&text, sizeof(text));
  Serial.println(text);
  Serial.println("received");
  delay(100);  
}
}
